caotiendattx/PC_ExtensionBoard/Docs/Canvas.png

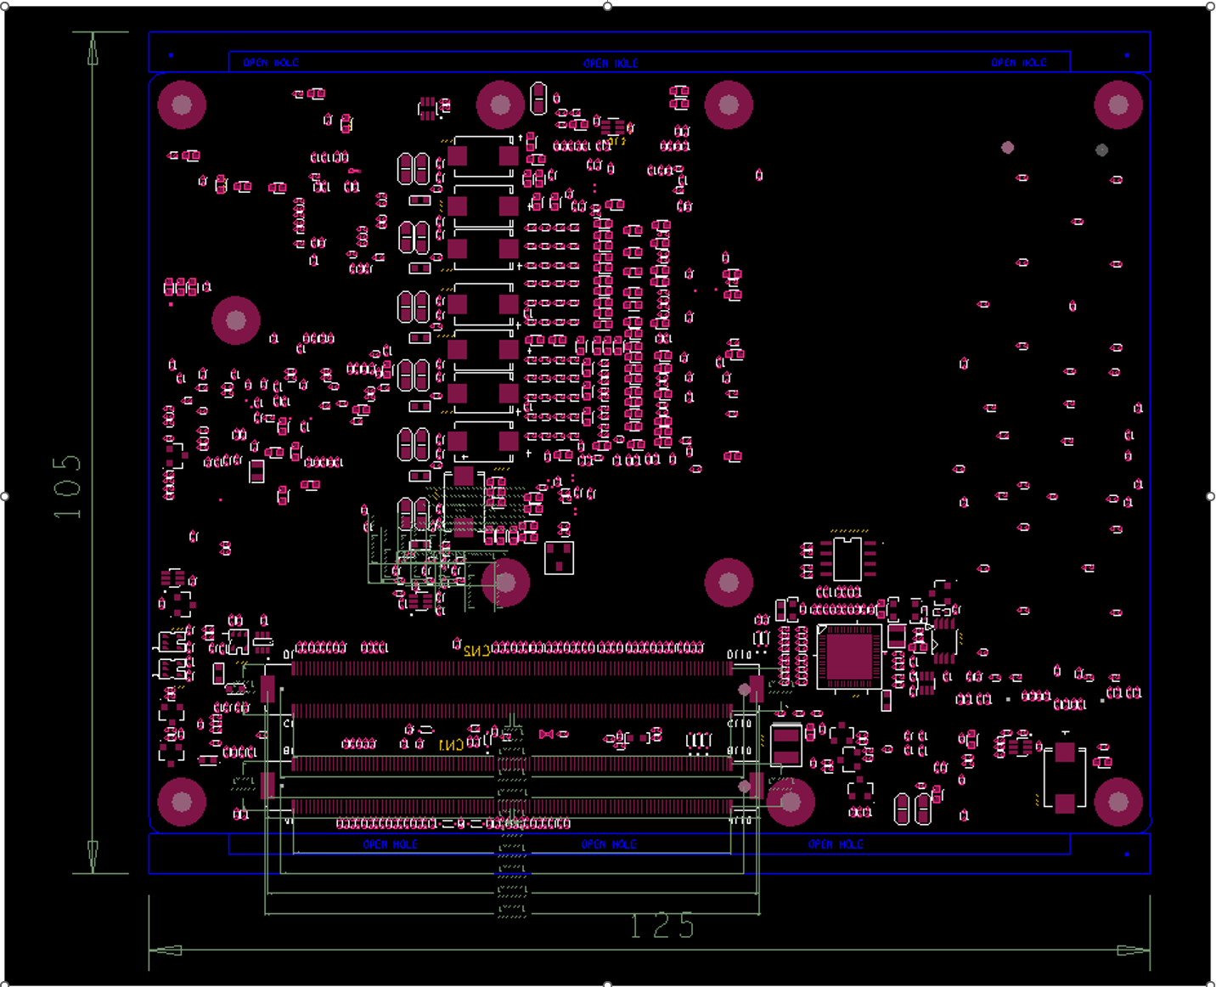
Docs/Canvas.png
