caotiendattx/PC_ExtensionBoard/Output/1.0/1.0_3D.png

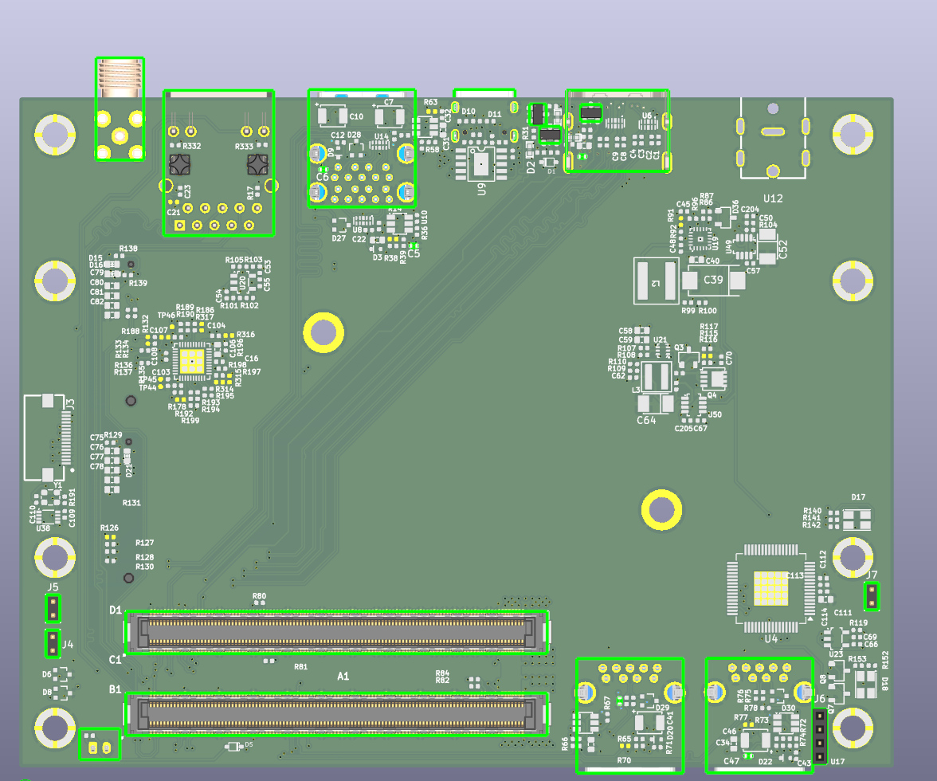
Output/1.0/1.0_3D.png
