caotiendattx/PC_ExtensionBoard/PC_ExtensionBoard/production/bom.csv

Designator | Footprint | Quantity | Value | LCSC Part #
BT1 | JST_PH_B2B-PH-K_1x02_P2.00mm_Vertical | 1 | Battery CMOS
C1, C19, C2, C20, C3, C30, C4, C8, C9 | 402 | 9 | 100nF/16V | C85960
C10, C41, C46, C7 | C_Pol_EIA-B | 4 | C_Pol_100u_10V_KEMET-T520-B | C600583
C103, C104, C107, C108, C109, C110, C112, C113, C114, C16, C17, C18, C204, C205, C23, C32, C37, C43, C48, C53, C54, C55 | 402 | 22 | C_100n_0402 | C85960
C106, C22, C31, C33, C34, C40, C58, C59 | 603 | 8 | C_22u_16V_0603 | C2762594
C11, C12, C38, C42, C44, C45, C47, C5, C50, C57, C6, C62, C66, C67, C69, C70 | 402 | 16 | C_1u_0402 | C2182694
C111, C75, C76, C77, C78, C79, C80, C81, C82 | 603 | 9 | C_22u_16V_0603 | CL10A226MO7JZNC
C39 | CAP-SMD_L7.3-W4.3-R-RD | 1 | C_Pol_68u_16V_Panasonic-TQC-D | C147770
C52, C64 | CAP-SMD_L3.5-W2.8 | 2 | C_Pol_100u_10V_KEMET-T520-B | C600583
C61 | 402 | 1 | 1uF/16V | C2182694
D1 | D_SOD-323 | 1 | 1N5819WS | C191023
D10, D11, D14, D19 | 402 | 4 | 0402ESDA-05N | C316049
D12 | 402 | 1 | PESD24VS1UL-N | C406227
D15, D16, D21 | 603 | 3 | LED_G_0603_LTST-C190GKT | LTST-C190GKT
D17, D18 | PLCC4_3.2x2.8mm | 2 | LED_RGB_PLCC4_ASMB_MTB1_0A3A2 | C2927824
D2, D4, D7 | D0402-BI | 3 | 0402ESDA-05N | C316049
D20, D22, D3, D9 | SOD-523 | 4 | PESD5Z5_0F | C552600
D27, D28, D29, D30, D6, D8 | SC70-3 | 6 | TPD2E2U06_SC70 | C1855726
D36 | SOT-23-3 | 1 | BAT54C | BAT54C
D5 | D_SOD-323 | 1 | D_Schottky | C168799
F1 | 603 | 1 | 6V/50mA | C7472508
H10, H11 | Spacer_Drill3.7mm_H2.5mm_9774025151R | 2 | Spacer_Drill3.7mm_H2.5mm_9774025151R | 9774025151R
H2, H3, H4, H5, H6, H7, H8, H9 | Spacer_Drill3.7mm_H5mm_9774050151R | 8 | Spacer_Drill3.7mm_H5mm_9774025151R | C7496631
HDMI1 | HDMI-SMD_HDMI-019S | 1 | HDMI_A | C111617
J100 | Bus_M.2_Socket_Key_E_TE_2199230-6 | 1 | Bus_M.2_2199230-2 | C23731731
J3 | FPC-SMD_P0.50-16P_FGS-XJ-H2.0 | 1 | Conn_01x16_MountingPin
J4, J5, J7 | PinHeader_1x02_P2.00mm_Vertical | 3 | Conn_01x02_Socket
J6 | PinSocket_1x04_P2.00mm_Vertical | 1 | Conn_01x04_Pin
J8 | Bus_M.2_Socket_Key_M_TE_1-2199230-6 | 1 | Bus_M.2_1-2199230-6 | C4710843
L2 | L_Coilcraft-XAL6030 | 1 | L_1u8_14A_Coilcraft-XAL6030 | XAL6030-182MEC
L3 | L_WE-MAPI-4020 | 1 | L_1u8_6.8A_WE-MAPI-4020 | C20636406
Q10, Q9 | SOT-23 | 2 | 2SK3018 | C727148
Q11 | SOT-23 | 1 | 2N7002 | C8545
Q3, Q7, Q8 | SOT-23-3 | 3 | BSS138-7-F | BSS138-7-F
Q4 | Vishay_PowerPAK_1212-8_Single | 1 | SI7613DN-T1-GE3 | SI7613DN-T1-GE3
R100, R107, R110 | 402 | 3 | R_15k_0402 | CR0402-FX-1502GLF
R101, R118 | 402 | 2 | R_100k_0402 | CR0402-FX-1003GLF
R102, R103, R119 | 402 | 3 | R_0R_0402 | ERJ2GE0R00X
R104, R113 | 402 | 2 | R_0R001_0805 | MSMA0805R0010FSM
R105, R191 | 402 | 2 | R_1k_0402 | CR0402-FX-1001GLF
R108, R116, R128, R136, R92, R96 | 402 | 6 | R_10k_0402 | CR0402-FX-1002GLF
R109 | 402 | 1 | R_110k_0402 | CR0402-FX-1103GLF
R117, R87 | 402 | 2 | R_30k_0402 | CR0402-FX-3002GLF
R126, R130, R132, R133, R134, R137, R192, R193, R194, R195, R32, R33, R38, R39, R58, R59, R61, R62, R65, R66, R68, R69, R72, R73, R75, R76 | 402 | 26 | R_0R_0402 | C242160
R129, R138, R139 | 402 | 3 | R_220R_0402 | CR0402-FX-2200GLF
R131 | 603 | 1 | R_0R_22.4A_0603 | PMR03EZPJ000
R14, R64, R71, R78 | 402 | 4 | R_2k2_0402 | C2076845
R140, R141, R142, R152, R153, R36, R60, R67, R74, R80, R81, R82, R84, R86 | 402 | 14 | R_10k_0402 | C202396
R15, R332, R333 | 402 | 3 | R_470R_0402 | C2077077
R17 | 402 | 1 | R_330R_0402 | C2077069
R186, R187, R189, R190, R196, R197, R198, R199 | 402 | 8 | R_1k_0402 | C202394
R28, R29, R31, R35 | 402 | 4 | 2.2K/1% | C25879
R37 | 402 | 1 | 10K/1% | C202396
R40 | 402 | 1 | 1K/1% | C202394
R41 | 402 | 1 | 1M/1% | C26083
R42 | 402 | 1 | 21.5K/1% | C25872
R47 | 402 | 1 | 24K/1% | C138026
R48 | 402 | 1 | 1K/1% | C11702
R99 | 402 | 1 | R_68k_0402 | CR0402-FX-6802GLF
RJ1 | RJ45-TH_HR911130A | 1 | HR911130A | C54408
SW1 | KEY-SMD_4P-L4.2-W3.2-P2.20-LS5.1-TL | 1 | K2-1808SN-A4SW | C92589
U1, U7 | USB-TH_USB3.0-A | 2 | HC-USB3.0-L168-WP | C7501850
U10, U13, U15, U17 | TSOT23-6 | 4 | AP22615A_TSOT26 | C2680357
U12 | DC-IN-TH_DC-528-2.0-HY | 1 | DC-528φ2.0(HY) | C2851176
U14, U16, U18, U8 | USON-10_2.5x1mm_P0.5mm | 4 | ESD204DQAR | C553132
U19 | QFN-20-1EP_3x3mm_P0.45mm_TPS56xxxx | 1 | TPS56C230 | TPS56C230RJER
U2 | SMA-TH_SMA-KWE | 1 | 10GHz | C7498154
U20 | SOT-23-5 | 1 | TPS3840PL30DBVR | TPS3840PL30DBVR
U21 | SOT-563 | 1 | TPS564247DRLR | TPS564247DRLR
U23 | SOT-23-5 | 1 | TLV73333PDBVT | TLV73333PDBVT
U3 | CORE_BOARD_CUSTOM_440_PIN | 1 | KBLH-E61_COMe_Type6_16U | C2761498
U37 | VFQFPN-40-1EP_5x5mm_P0.4mm_EP3.5x3.5mm | 1 | 9DBL0651CKILF | 9DBL0651CKILF
U38 | VSSOP-8_2.3x2mm_P0.5mm | 1 | 74AUP2G132 | 74AUP2G132
U4 | LQFP-64-1EP_10x10mm_P0.5mm_EP5x5mm | 1 | STM32G0B1RCT6 | C3034735
U49, U50 | SOT-23-8 | 2 | INA219AIDCNR | INA219AIDCNR
U5, U6 | DFN2510-10_L2.5-W1.0-P0.50-BL | 2 | TPAZ1023-04F | C2827676
U9 | ESSOP-10_L4.9-W3.9-P1.0-LS6.0-TL-EP | 1 | CH224K | C970725
USB1 | USB-A-TH_H181-AF2R06-12ALCR | 1 | HC-USB3.0-L175-2X1-P | C7501881
USBC1 | USB-C_SMD-TYPE-C-31-M-12_1 | 1 | J18 | C165948
Y1 | Oscillator_SMD_ECS_2520MV_2.5x2mm | 1 | Oscillator_32.768kHz_ECS_2520MV | ECS-327MVATX-2-CN-TR3
U333 | CORE_BOARD_CUSTOM_440_PIN | 1 | KBLH-E61_COMe_Type6_16U | C2761498
