caotiendattx/PC_ExtensionBoard/PC_ExtensionBoard_Lib2/parts/BORN_0402ESDA_05N/D0402_L1-W0.5-H0.4-LS1.0.step

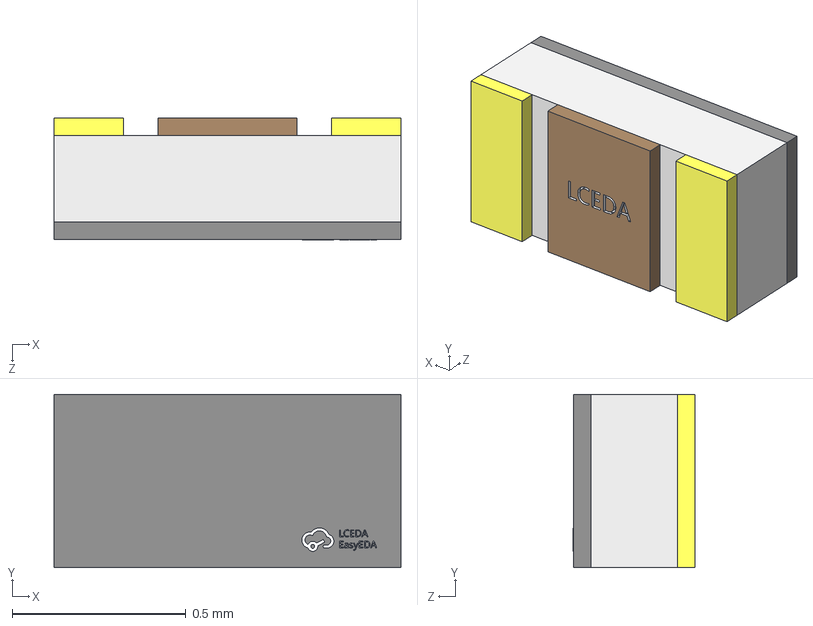
[picture p14: CAD file, 2026-06-15]
PC_ExtensionBoard_Lib2/parts/BORN_0402ESDA_05N/D0402_L1-W0.5-H0.4-LS1.0.step
1.00 x 0.5 x 0.351 mm
