caotiendattx/PC_ExtensionBoard/PC_ExtensionBoard_Lib2/parts/HANRUN_HR911130A/RJ45-TH_HR911130A.STEP

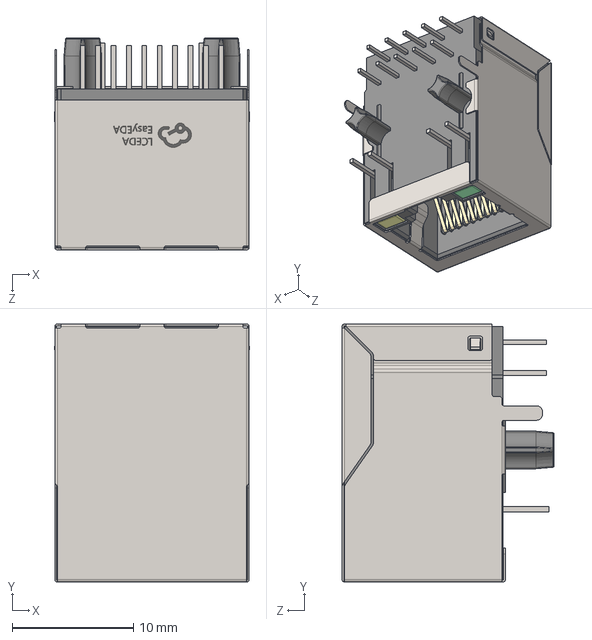
[picture p15: CAD file, 2026-06-11]
PC_ExtensionBoard_Lib2/parts/HANRUN_HR911130A/RJ45-TH_HR911130A.STEP
16.1 x 21.3 x 17.5 mm
