caotiendattx/PC_ExtensionBoard/PC_ExtensionBoard_Lib2/parts/Hong_Cheng_HC_USB3_0_L175_2X1_P/USB-A-TH_H181-AF2R06-12ALCR.STEP

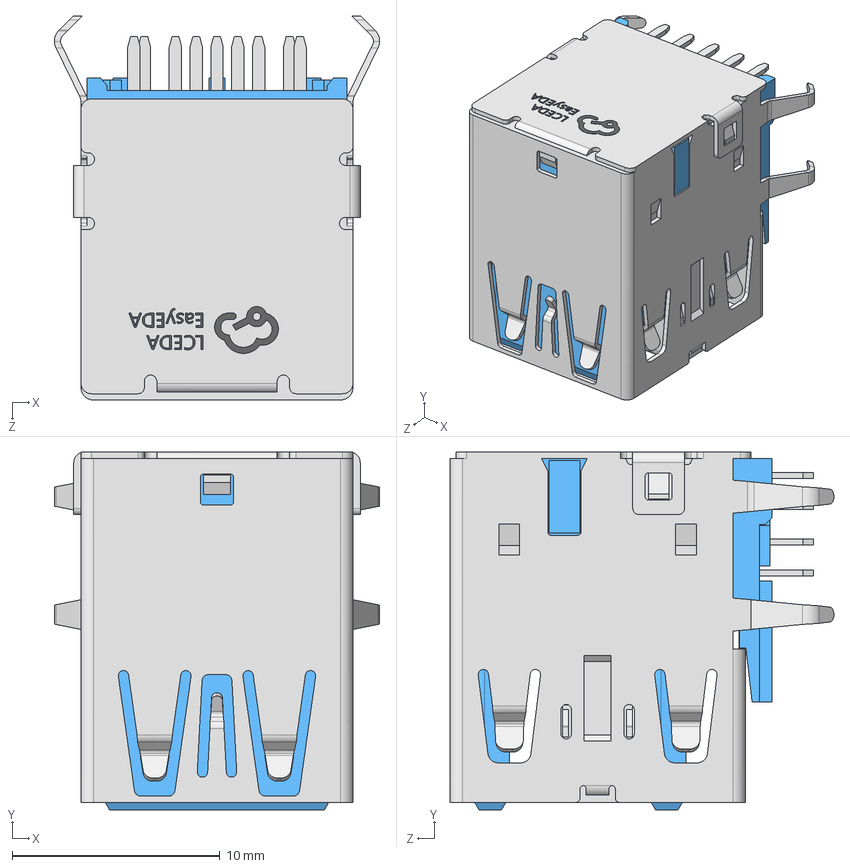
[picture p16: CAD file, 2026-04-27]
PC_ExtensionBoard_Lib2/parts/Hong_Cheng_HC_USB3_0_L175_2X1_P/USB-A-TH_H181-AF2R06-12ALCR.STEP
15.7 x 17.2 x 18.5 mm
