caotiendattx/PC_ExtensionBoard/PC_ExtensionBoard_Lib2/parts/JUSHUO_AFA01_S16FCC_00/FPC-SMD_P1.00-16P_FGS-XJ-H2.0.step

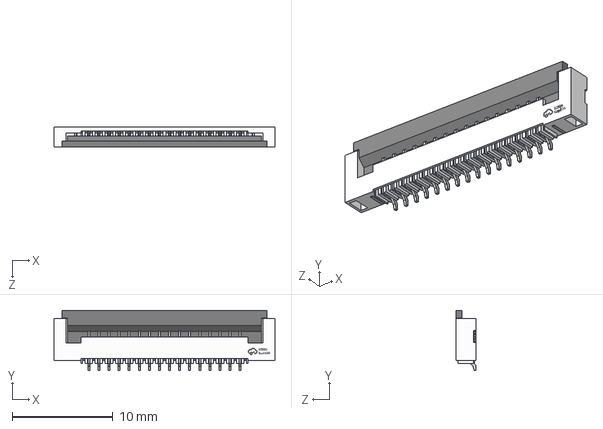
[picture p17: CAD file, 2026-06-14]
PC_ExtensionBoard_Lib2/parts/JUSHUO_AFA01_S16FCC_00/FPC-SMD_P1.00-16P_FGS-XJ-H2.0.step
21.9 x 5.97 x 2.01 mm
