caotiendattx/PC_ExtensionBoard/PC_ExtensionBoard_Lib2/parts/JUSHUO_AFC01_S16FCC_00/FPC-SMD_P0.50-16P_FGS-XJ-H2.0.step

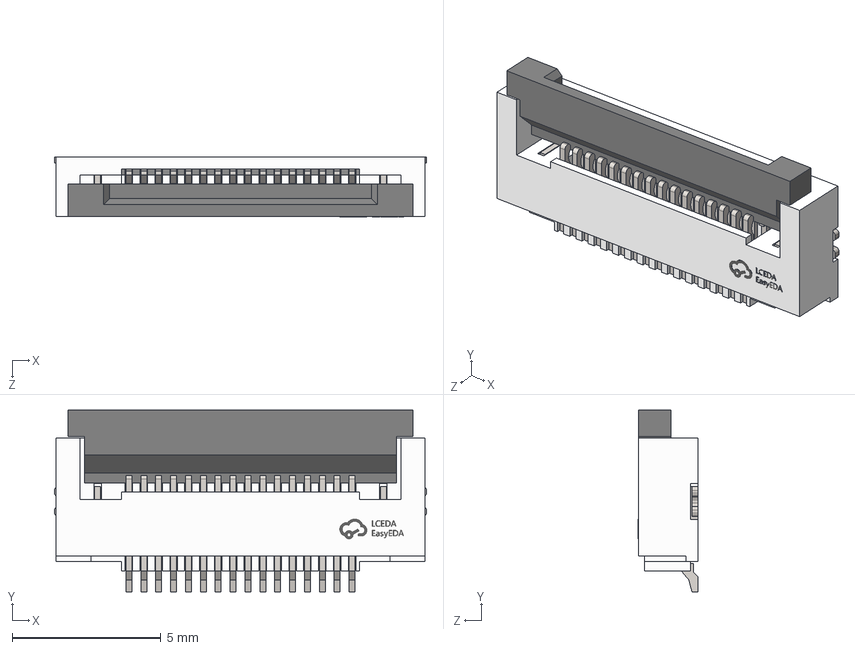
[picture p18: CAD file, 2026-06-14]
PC_ExtensionBoard_Lib2/parts/JUSHUO_AFC01_S16FCC_00/FPC-SMD_P0.50-16P_FGS-XJ-H2.0.step
12.5 x 6.10 x 2.01 mm
