caotiendattx/PC_ExtensionBoard/PC_ExtensionBoard_Lib2/parts/KEMET_T520B107M010ATE070/CASE-B_L3.5-W2.8-H1.9.step

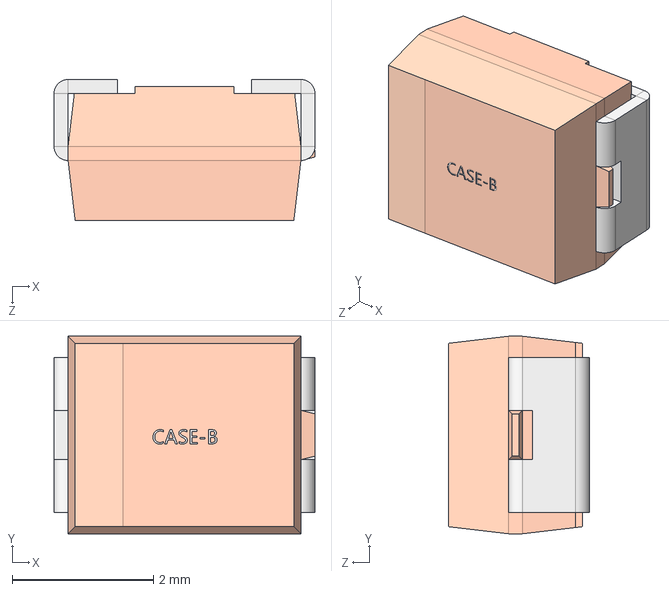
[picture p19: CAD file, 2026-06-15]
PC_ExtensionBoard_Lib2/parts/KEMET_T520B107M010ATE070/CASE-B_L3.5-W2.8-H1.9.step
3.70 x 2.80 x 2.00 mm
