caotiendattx/PC_ExtensionBoard/PC_ExtensionBoard_Lib2/parts/Korean_Hroparts_Elec_K2_1808SN_A4SW_01/KEY-SMD_4P-L4.2-W3.2-H2.5-LS5.1-P2.2.step

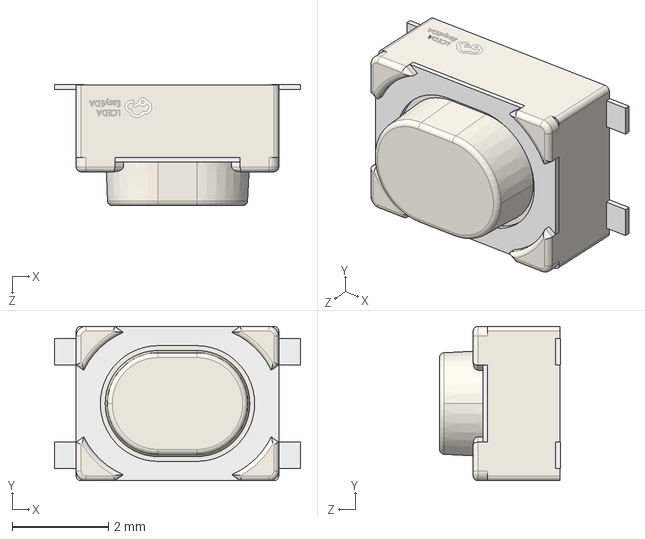
[picture p20: CAD file, 2026-06-11]
PC_ExtensionBoard_Lib2/parts/Korean_Hroparts_Elec_K2_1808SN_A4SW_01/KEY-SMD_4P-L4.2-W3.2-H2.5-LS5.1-P2.2.step
5.10 x 3.20 x 2.51 mm
