caotiendattx/PC_ExtensionBoard/PC_ExtensionBoard_Lib2/parts/Korean_Hroparts_Elec_PJ_393_7A/AUDIO-SMD_PJ-393-7A.step

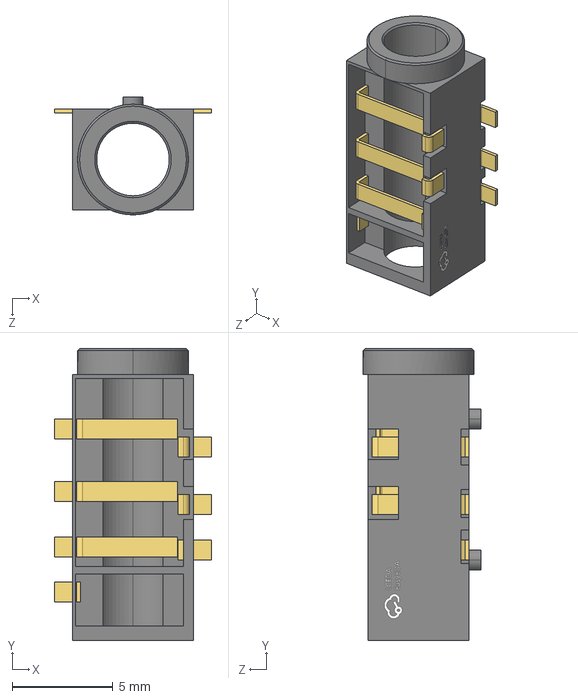
[picture p21: CAD file, 2026-06-11]
PC_ExtensionBoard_Lib2/parts/Korean_Hroparts_Elec_PJ_393_7A/AUDIO-SMD_PJ-393-7A.step
7.80 x 14.5 x 5.85 mm
