caotiendattx/PC_ExtensionBoard/PC_ExtensionBoard_Lib2/parts/PANASONIC_16TQC68MYF/CASE-E_L7.3-W4.3-H4.1.step

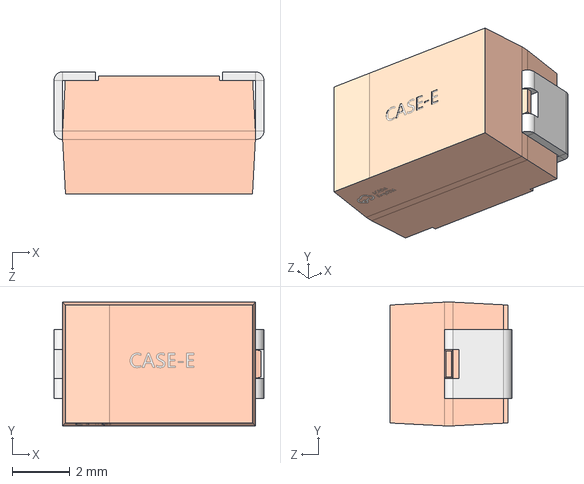
[picture p22: CAD file, 2026-06-15]
PC_ExtensionBoard_Lib2/parts/PANASONIC_16TQC68MYF/CASE-E_L7.3-W4.3-H4.1.step
7.30 x 4.30 x 4.25 mm
