caotiendattx/PC_ExtensionBoard/PC_ExtensionBoard_Lib2/parts/Shenzhen_Kinghelm_Elec_KH_FG0_5_H2_0_16PIN/FPC-SMD_KH-FG0.5-H2.0-16PIN.step

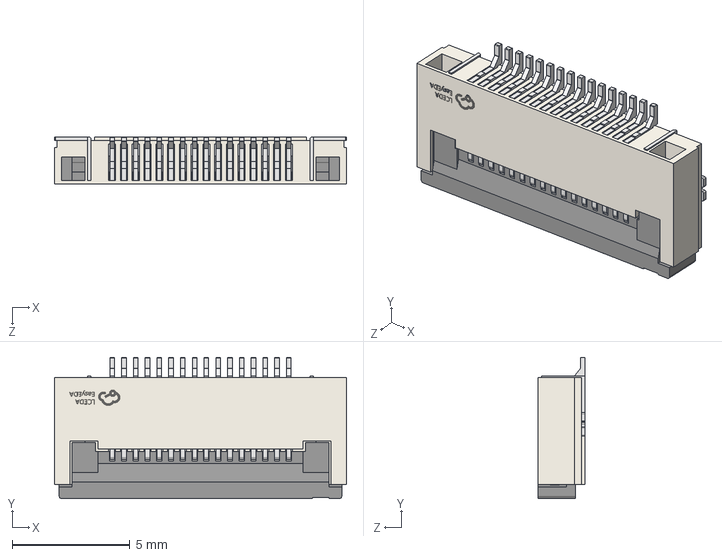
[picture p23: CAD file, 2026-06-11]
PC_ExtensionBoard_Lib2/parts/Shenzhen_Kinghelm_Elec_KH_FG0_5_H2_0_16PIN/FPC-SMD_KH-FG0.5-H2.0-16PIN.step
12.4 x 6.00 x 2.01 mm
