caotiendattx/PC_ExtensionBoard/PC_ExtensionBoard_Lib2/parts/SOFNG_HDMI_019S/HDMI-SMD_HDMI-019S.step

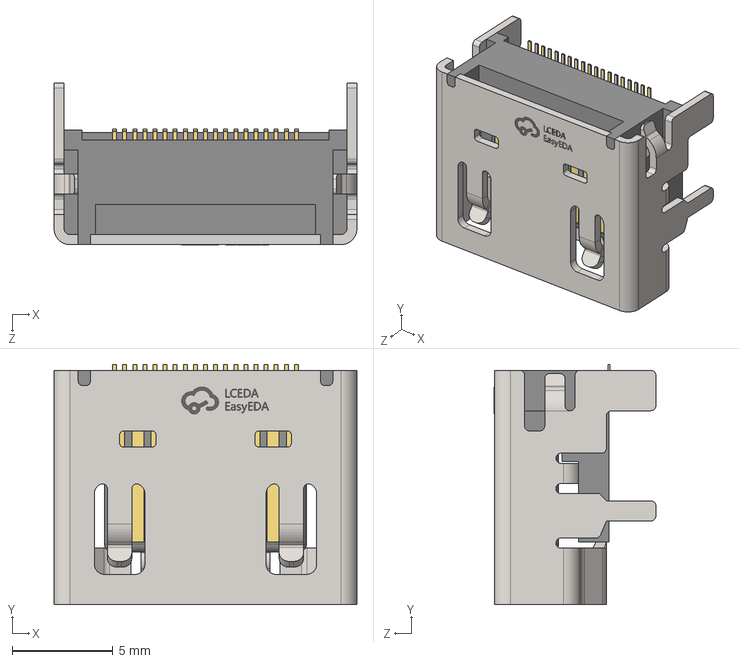
[picture p24: CAD file, 2026-04-27]
PC_ExtensionBoard_Lib2/parts/SOFNG_HDMI_019S/HDMI-SMD_HDMI-019S.step
15.0 x 11.9 x 8.01 mm
