caotiendattx/PC_ExtensionBoard/PC_ExtensionBoard_Lib2/parts/TE_Connectivity_1_2199230_6/PCIE-SMD_1-2199230-6.STEP

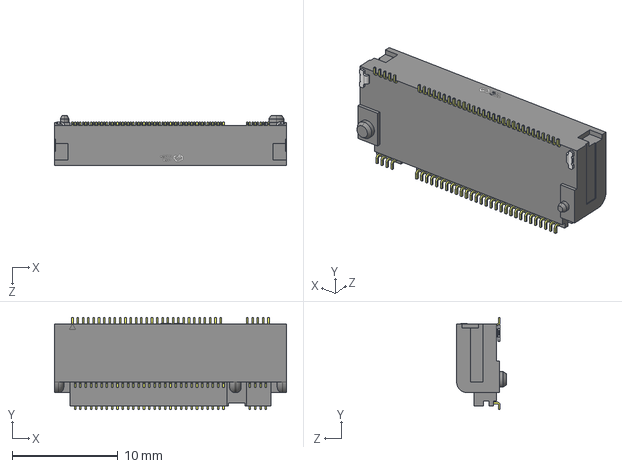
[picture p25: CAD file, 2026-06-11]
PC_ExtensionBoard_Lib2/parts/TE_Connectivity_1_2199230_6/PCIE-SMD_1-2199230-6.STEP
21.9 x 8.70 x 4.70 mm
