caotiendattx/PC_ExtensionBoard/PC_ExtensionBoard_Lib2/parts/TECH_PUBLIC_TPAZ1023_04F/DFN-10_L2.5-W1.0-H0.5-P0.50.step

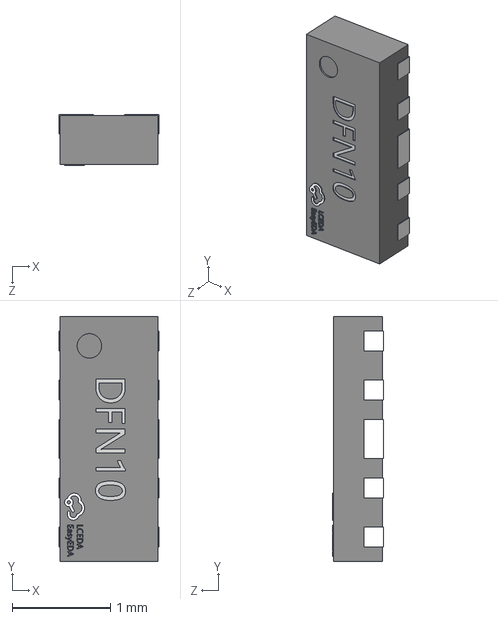
[picture p26: CAD file, 2026-06-15]
PC_ExtensionBoard_Lib2/parts/TECH_PUBLIC_TPAZ1023_04F/DFN-10_L2.5-W1.0-H0.5-P0.50.step
1.02 x 2.50 x 0.52 mm
