caotiendattx/PC_ExtensionBoard/PC_ExtensionBoard_Lib2/parts/Texas_Instruments_PCM2912APJTR/TQFP-32_L7.0-W7.0-H1.2-LS9.0-P0.80.step

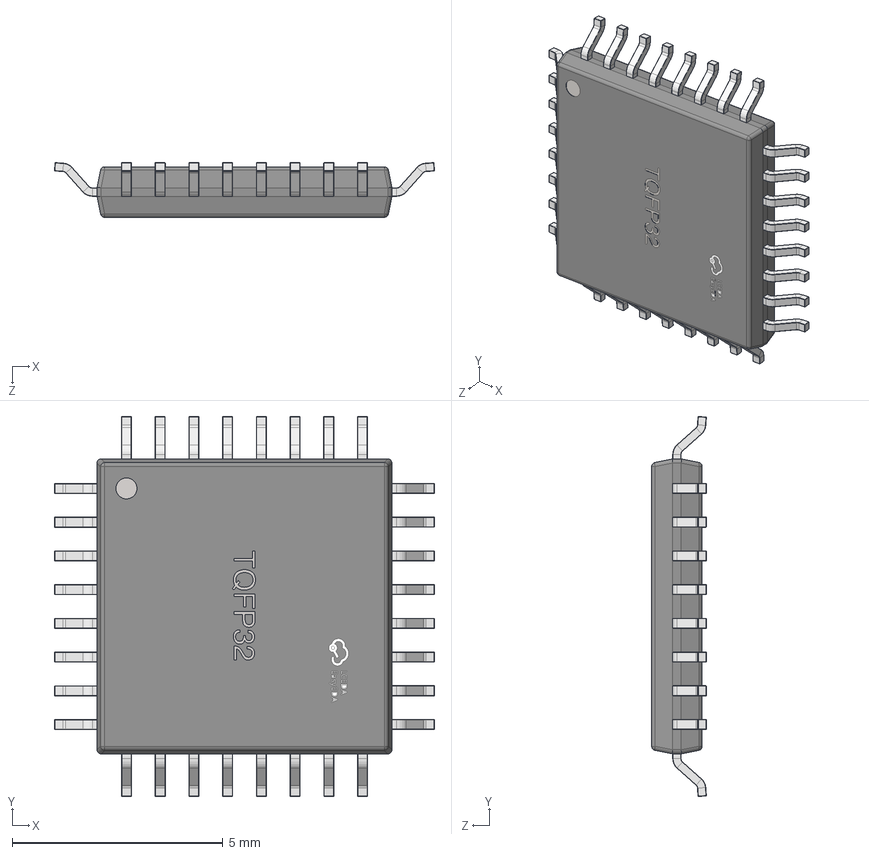
[picture p27: CAD file, 2026-06-11]
PC_ExtensionBoard_Lib2/parts/Texas_Instruments_PCM2912APJTR/TQFP-32_L7.0-W7.0-H1.2-LS9.0-P0.80.step
9.02 x 9.02 x 1.30 mm
