caotiendattx/PC_ExtensionBoard/PC_ExtensionBoard_Lib2/parts/XUNPU_FPC_05F_24PH20/FPC-SMD_24P-P0.50_FPC-05F-24PH20.STEP

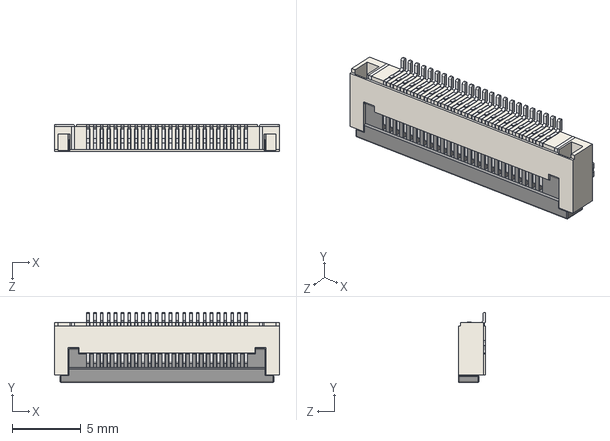
[picture p29: CAD file, 2026-06-11]
PC_ExtensionBoard_Lib2/parts/XUNPU_FPC_05F_24PH20/FPC-SMD_24P-P0.50_FPC-05F-24PH20.STEP
16.4 x 5.12 x 2.00 mm
