caotiendattx/PC_ExtensionBoard/(list of files, cad)

Other CAD files:
PC_ExtensionBoard_Lib2/parts/TE_CONNECTIVITY_2199230_2/PCIE-SMD_2199230-4.STEP
