caotiendattx/PC_ExtensionBoard/PC_ExtensionBoard/PC_ExtensionBoard.kicad_pcb

## KiCad design PC_ExtensionBoard/PC_ExtensionBoard.kicad_pcb (2026-06-24)

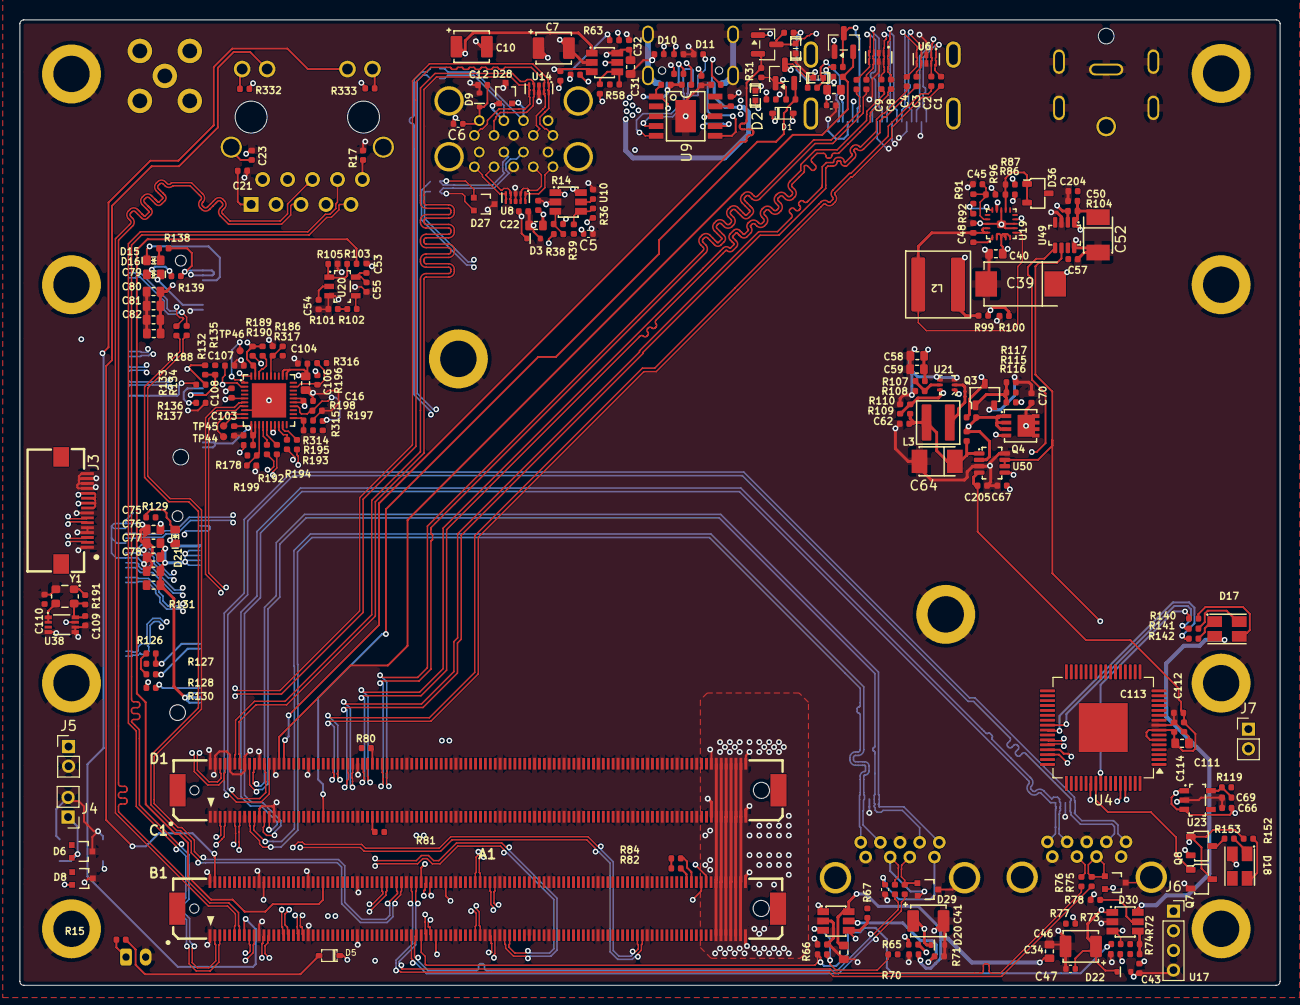
[picture p30: board PC_ExtensionBoard.kicad_pcb from above]

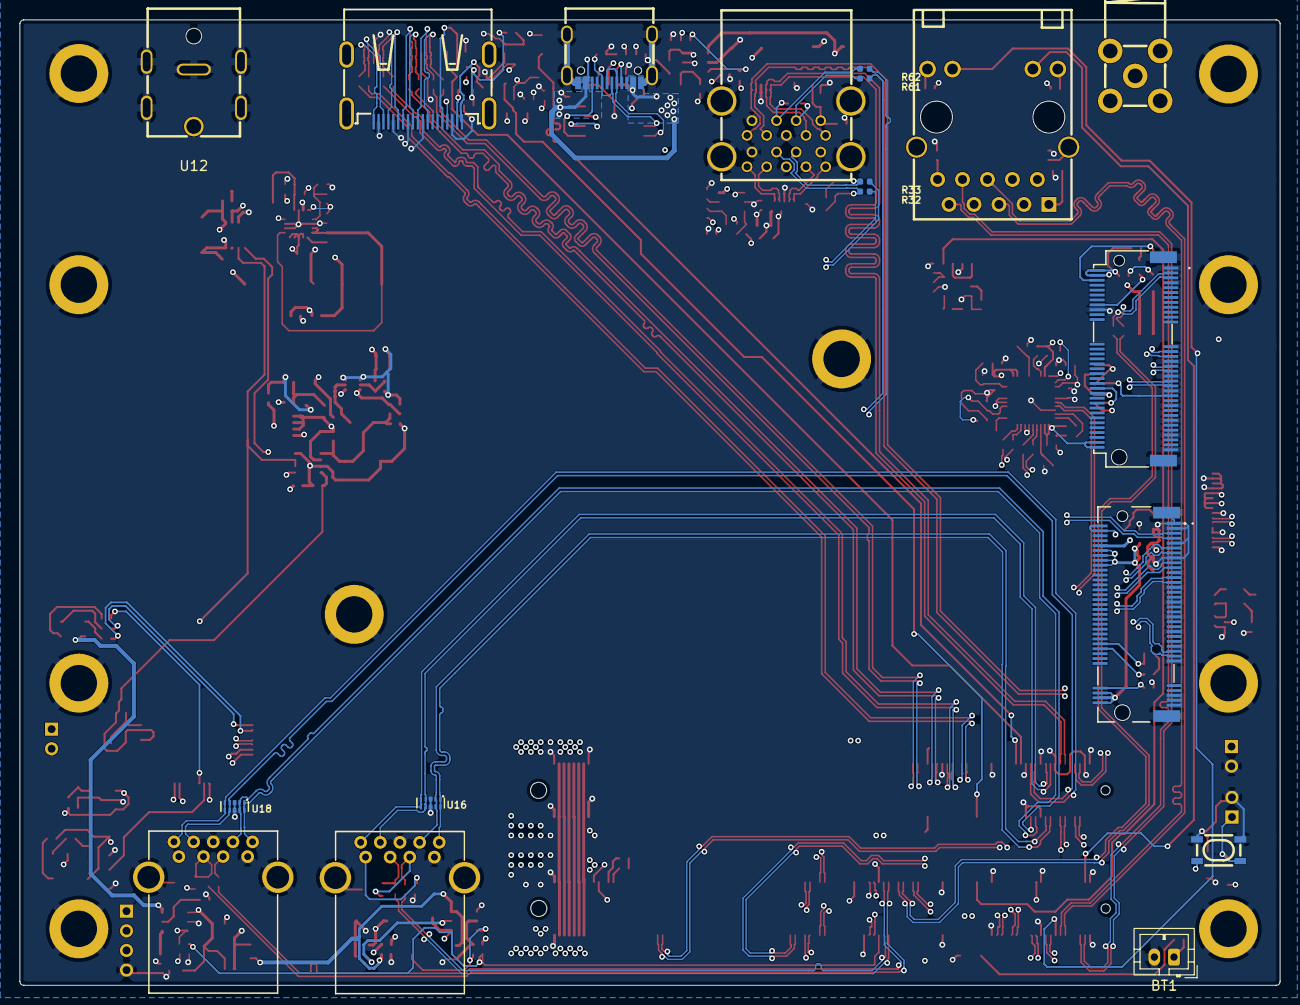
[picture p31: board PC_ExtensionBoard.kicad_pcb from below]

Board: 6 copper layers, 128.2 x 98.2 mm, 269 parts (22 on the bottom side), 216 nets.

Parts:
A1: Mech_M2_2280_H2.5mm
A4: Mech_M2_2230_H2.5mm
BT1: Battery CMOS; JST_PH_B2B-PH-K_1x02_P2.00mm_Vertical
C1, C2, C3, C4, C8, C9, C19, C20, C30: 100nF/16V; C_0402_1005Metric
C5, C6, C11, C12, C38, C42, C44, C45, C47, C50, C57, C62, C66, C67, C69, C70: C_1u_0402; C_0402_1005Metric
C7, C10, C41, C46: C_Pol_100u_10V_KEMET-T520-B; C_Pol_EIA-B
C16, C17, C18, C21, C23, C32, C37, C43, C48, C53, C54, C55, C103, C104, C107, C108, C109, C110, C112, C113, C114, C204, C205: C_100n_0402; C_0402_1005Metric
C22, C31, C33, C34, C40, C58, C59, C75, C76, C77, C78, C79, C80, C81, C82, C106, C111: C_22u_16V_0603; C_0603_1608Metric
C39: C_Pol_68u_16V_Panasonic-TQC-D; CAP-SMD_L7.3-W4.3-R-RD
C52, C64: C_Pol_100u_10V_KEMET-T520-B; CAP-SMD_L3.5-W2.8
C61: 1uF/16V; C_0402_1005Metric
D1: 1N5819WS; D_SOD-323
D2, D4, D7: 0402ESDA-05N; D0402-BI
D3, D9, D20, D22: PESD5Z5_0F; SOD-523
D5: D_Schottky; D_SOD-323
D6, D8, D27, D28, D29, D30: TPD2E2U06_SC70; SC70-3
D10, D11, D14, D19: 0402ESDA-05N; C_0402_1005Metric
D12: PESD24VS1UL-N; C_0402_1005Metric
D15, D16, D21: LED_G_0603_LTST-C190GKT; LED_0603_1608Metric_G
D17, D18: LED_RGB_PLCC4_ASMB_MTB1_0A3A2; PLCC4_3.2x2.8mm
D36: BAT54C; SOT-23-3
F1: 6V/50mA; R_0603_1608Metric
H2, H3, H4, H5, H6, H7, H8, H9: Spacer_Drill3.7mm_H5mm_9774025151R; Spacer_Drill3.7mm_H5mm_9774050151R
H10, H11: Spacer_Drill3.7mm_H2.5mm_9774025151R
HDMI1: HDMI_A; HDMI-SMD_HDMI-019S
J3: Conn_01x16_MountingPin; FPC-SMD_P0.50-16P_FGS-XJ-H2.0
J4, J5, J7: Conn_01x02_Socket; PinHeader_1x02_P2.00mm_Vertical
J6: Conn_01x04_Pin; PinSocket_1x04_P2.00mm_Vertical
J8: Bus_M.2_1-2199230-6; Bus_M.2_Socket_Key_M_TE_1-2199230-6
J100: Bus_M.2_2199230-2; Bus_M.2_Socket_Key_E_TE_2199230-6
L2: L_1u8_14A_Coilcraft-XAL6030; L_Coilcraft-XAL6030
L3: L_1u8_6.8A_WE-MAPI-4020; L_WE-MAPI-4020
Q3, Q7, Q8: BSS138-7-F; SOT-23-3
Q4: SI7613DN-T1-GE3; Vishay_PowerPAK_1212-8_Single
Q9, Q10: 2SK3018; SOT-23
Q11: 2N7002; SOT-23
R14, R64, R71, R78: R_2k2_0402; C_0402_1005Metric
R15, R332, R333: R_470R_0402; R_0402_1005Metric
R17: R_330R_0402; R_0402_1005Metric
R28, R29, R31, R35: 2.2K/1%; R_0402_1005Metric
R30, R36, R60, R63, R67, R70, R74, R77, R80, R81, R82, R84, R86, R92, R96, R108, R116, R127, R128, R135, R136, R140, R141, R142, R152, R153: R_10k_0402; R_0402_1005Metric
R32, R33, R38, R39, R58, R59, R61, R62, R65, R66, R68, R69, R72, R73, R75, R76, R102, R103, R115, R119, R126, R130, R132, R133, R134, R137, R178, R192, R193, R194, R195, R314, R315, R316, R317: R_0R_0402; R_0402_1005Metric
R37: 10K/1%; R_0402_1005Metric
R40, R48: 1K/1%; R_0402_1005Metric
R41: 1M/1%; R_0402_1005Metric
R42: 21.5K/1%; R_0402_1005Metric
R47: 24K/1%; C_0402_1005Metric
R87, R117: R_30k_0402; R_0402_1005Metric
R91, R99: R_68k_0402; R_0402_1005Metric
R100, R107, R110: R_15k_0402; R_0402_1005Metric
R101, R118: R_100k_0402; R_0402_1005Metric
R104, R113: R_0R001_0805; R_0402_1005Metric
R105, R186, R187, R188, R189, R190, R191, R196, R197, R198, R199: R_1k_0402; R_0402_1005Metric
R109: R_110k_0402; R_0402_1005Metric
R129, R138, R139: R_220R_0402; R_0402_1005Metric
R131: R_0R_22.4A_0603; R_0603_1608Metric
RJ1: HR911130A; RJ45-TH_HR911130A
SW1: K2-1808SN-A4SW; KEY-SMD_4P-L4.2-W3.2-P2.20-LS5.1-TL
TP44, TP45, TP46: TP_0.75mm_SMD; TP_SMD_0.75mm
U1, U7: HC-USB3.0-L168-WP; USB-TH_USB3.0-A
U2: 10GHz; SMA-TH_SMA-KWE
U3: KBLH-E61_COMe_Type6_16U; CORE_BOARD_CUSTOM_440_PIN
U4: STM32G0B1RCT6; LQFP-64-1EP_10x10mm_P0.5mm_EP5x5mm
U5, U6: TPAZ1023-04F; DFN2510-10_L2.5-W1.0-P0.50-BL
U8, U14, U16, U18: ESD204DQAR; USON-10_2.5x1mm_P0.5mm
U9: CH224K; ESSOP-10_L4.9-W3.9-P1.0-LS6.0-TL-EP
U10, U13, U15, U17: AP22615A_TSOT26; TSOT23-6
U12: DC-528φ2.0(HY); DC-IN-TH_DC-528-2.0-HY
U19: TPS56C230; QFN-20-1EP_3x3mm_P0.45mm_TPS56xxxx
U20: TPS3840PL30DBVR; SOT-23-5
U21: TPS564247DRLR; SOT-563
U23: TLV73333PDBVT; SOT-23-5
U37: 9DBL0651CKILF; VFQFPN-40-1EP_5x5mm_P0.4mm_EP3.5x3.5mm
U38: 74AUP2G132; VSSOP-8_2.3x2mm_P0.5mm
U49, U50: INA219AIDCNR; SOT-23-8
USB1: HC-USB3.0-L175-2X1-P; USB-A-TH_H181-AF2R06-12ALCR
USBC1: J18; USB-C_SMD-TYPE-C-31-M-12_1
Y1: Oscillator_32.768kHz_ECS_2520MV; Oscillator_SMD_ECS_2520MV_2.5x2mm

Connections:
5V_HDMI_VCC: C30.1, D1.1 (K), F1.1, R28.1, R29.1
+3.3V: C16.2, C17.2, C57.2, C79.2, C80.2, C81.2, C82.2, C103.2, C104.2, C106.2, C107.2, C108.2, C109.2, C110.2, J100.2 (3.3V), J100.4 (3.3V), J100.72 (3.3V), J100.74 (3.3V), Q9.1 (G), Q10.1 (G), Q11.1 (G), R30.2, R31.1, R35.1, R36.2, R41.1, R60.2, R63.2, R67.2, R70.2, R74.2, R77.2, R80.1, R81.1, R82.1, R84.1, R104.2, R127.2, R128.2, R129.2, R131.2, R135.2, R136.2, R138.2, R139.2, R187.1, R189.2, R190.1, R191.2, R332.2, R333.2, U37.5 (VDDR), U37.11 (VDDDIG3V3), U37.12 (VDDIO), U37.16 (VDD3V3), U37.17 (VDDIO), U37.25 (VDDA3V3), U37.26 (VDDIO), U37.31 (VDD3V3), U37.32 (VDDIO), U37.39 (VDDIO), U38.8 (VCC), U49.2 (IN-), Y1.4 (VDD)
+3V3_AON: C54.2, C111.2, C112.2, C113.2, C114.2, C204.2, C205.2, R119.2, U4.6 (VBAT), U4.8 (VDD), U20.2 (VDD), U49.4 (V_{S}), U49.7 (A0), U50.4 (V_{S})
+5V: C18.2, C22.2, C31.2, C32.2, C33.2, C34.2, C37.2, C43.2, C70.2, D1.2 (A), D17.4 (A), J3.9, J3.10, J3.11, J3.12, Q4.5 (D), R86.2, U10.6 (IN), U13.6 (IN), U15.6 (IN), U17.6 (IN)
+5V_AON: C66.2, C67.2, D18.4 (A), Q4.1 (S), Q4.2 (S), Q4.3 (S), R113.2, R118.2, U23.1 (VIN), U23.3 (EN), U50.2 (IN-)
+12V: C39.1, C40.2, C58.2, C59.2, D12.1 (K), J6.3, R37.1, R40.1, R107.2, R116.2, U3.A104 (VCC_12V), U3.A105 (VCC_12V), U3.A106 (VCC_12V), U3.A107 (VCC_12V), U3.A108 (VCC_12V), U3.A109 (VCC_12V), U3.B104 (VCC_12V), U3.B105 (VCC_12V), U3.B106 (VCC_12V), U3.B107 (VCC_12V), U3.B108 (VCC_12V), U3.B109 (VCC_12V), U3.C104 (VCC_12V), U3.C105 (VCC_12V), U3.C106 (VCC_12V), U3.C107 (VCC_12V), U3.C108 (VCC_12V), U3.C109 (VCC_12V), U3.D104 (VCC_12V), U3.D105 (VCC_12V), U3.D106 (VCC_12V), U3.D107 (VCC_12V), U3.D108 (VCC_12V), U3.D109 (VCC_12V), U12.4, U19.2 (V_{IN}), U19.3 (V_{IN}), U19.4 (V_{IN}), U19.5 (V_{IN}), U21.1 (V_{IN}), USBC1.A4B9 (VBUS), USBC1.B4A9 (VBUS)
/HDMI/DDC_SCL: D2.2 (A2), HDMI1.15 (SCL), Q9.3 (D), R29.2
/HDMI/DDC_SDA: D4.2 (A2), HDMI1.16 (SDA), Q10.3 (D), R28.2
/HDMI/DDI1.SCL: Q9.2 (S), R35.2, U3.D15 (DDI1_CTRLCLK_AUX+)
/HDMI/DDI1.SDA: Q10.2 (S), R31.2, U3.D16 (DDI1_CTRLDATA_AUX)
/HDMI/DDI1.TX0+: C1.1, U3.D26 (DDI1_PAIR0+)
/HDMI/DDI1.TX0-: C2.1, U3.D27 (DDI1_PAIR0-)
/HDMI/DDI1.TX1+: C3.1, U3.D29 (DDI1_PAIR1+)
/HDMI/DDI1.TX1-: C4.1, U3.D30 (DDI1_PAIR1-)
/HDMI/DDI1.TX2+: C8.1, U3.D32 (DDI1_PAIR2+)
/HDMI/DDI1.TX2-: C9.1, U3.D33 (DDI1_PAIR2-)
/HDMI/DDI1.TX3+: C19.1, U3.D36 (DDI1_PAIR3+)
/HDMI/DDI1.TX3-: C20.1, U3.D37 (DDI1_PAIR3-)
/HDMI/DDI1_AUX_SEL: R80.2, U3.D34 (DDI1_DDC_AUX_SEL)
/HDMI/DDI1_HPD: Q11.2 (S), R41.2, U3.C24 (DDI1_HPD)
/HDMI/DDI2_AUX_SEL: R81.2, U3.C34 (DDI2_DDC_AUX_SEL)
/HDMI/HPD: D7.2 (A2), HDMI1.19 (HPD), R48.2
/HDMI/TMDS_CK+: C19.2, HDMI1.10 (CK+), U5.4, U5.7 (NC)
/HDMI/TMDS_CK-: C20.2, HDMI1.12 (CK-), U5.5, U5.6 (NC)
/HDMI/TMDS_D0+: C8.2, HDMI1.7 (D0+), U5.1, U5.10 (NC)
/HDMI/TMDS_D0-: C9.2, HDMI1.9 (D0-), U5.2, U5.9 (NC)
/HDMI/TMDS_D1+: C3.2, HDMI1.4 (D1+), U6.4, U6.7 (NC)
/HDMI/TMDS_D1-: C4.2, HDMI1.6 (D1-), U6.5, U6.6 (NC)
/HDMI/TMDS_D2+: C1.2, HDMI1.1 (D2+), U6.1, U6.10 (NC)
/HDMI/TMDS_D2-: C2.2, HDMI1.3 (D2-), U6.2, U6.9 (NC)
/M.2 Key E/PCIE_REF3.CK+: J100.49 (REFCLK0_N), R195.2
/M.2 Key E/PCIE_REF3.CK-: J100.47 (REFCLK0_P), R194.2
/M.2 Key E/PCIe_B1x2.RX0+: J100.43 (PER0_N), U3.A55 (PCIE_TX4+)
/M.2 Key E/PCIe_B1x2.RX0-: J100.41 (PER0_P), U3.A56 (PCIE_TX4-)
/M.2 Key E/PCIe_B1x2.TX0+: J100.37 (PET0_N), U3.B55 (PCIE_RX4+)
/M.2 Key E/PCIe_B1x2.TX0-: J100.35 (PET0_P), U3.B56 (PCIE_RX4-)
/M.2 Key E/SUSCLK: R130.2, R137.2, U38.7 (1Y)
/M.2 Key E/USB.D+: R133.1, U3.B40 (USB5+)
/M.2 Key E/USB.D-: R134.1, U3.B39 (USB5-)
/M.2 Key E/WIFI_BT_USB_D_N: J100.5 (USB_D_N), R134.2
/M.2 Key E/WIFI_BT_USB_D_P: J100.3 (USB_D_P), R133.2
/M.2 Key E/~CLKREQ: J100.53 (~CLKREQ0), R136.1
/M.2 Key E/~LED_1: D15.1 (C), J100.6 (~LED_1)
/M.2 Key E/~LED_2: D16.1 (C), J100.16 (~LED_2)
/M.2 Key E/~PERST_D: J100.52 (~PERST0), R132.2, R135.1
/M.2 Key M #1/M2_3V3: C75.2, C76.2, C77.2, C78.2, J8.2 (3V3), J8.4 (3V3), J8.12 (3V3), J8.14 (3V3), J8.16 (3V3), J8.18 (3V3), J8.70 (3V3), J8.72 (3V3), J8.74 (3V3), R131.1
/M.2 Key M #1/PCIE1-4_SATA_PCIE: R82.2, U3.B98 (PCIE1-4_SATA_PCIE)
/M.2 Key M #1/PCIE_REF0.CK+: J8.55 (REFCLK_P), R192.2
/M.2 Key M #1/PCIE_REF0.CK-: J8.53 (REFCLK_N), R193.2
/M.2 Key M #1/PCIe_B1x4.RX0+: J8.41 (PER0_N), U3.A68 (PCIE_TX0+)
/M.2 Key M #1/PCIe_B1x4.RX0-: J8.43 (PER0_P), U3.A69 (PCIE_TX0-)
/M.2 Key M #1/PCIe_B1x4.RX1+: J8.29 (PER1_N), U3.A64 (PCIE_TX1+)
/M.2 Key M #1/PCIe_B1x4.RX1-: J8.31 (PER1_P), U3.A65 (PCIE_TX1-)
/M.2 Key M #1/PCIe_B1x4.RX2+: J8.17 (PER2_N), U3.A61 (PCIE_TX2+)
/M.2 Key M #1/PCIe_B1x4.RX2-: J8.19 (PER2_P), U3.A62 (PCIE_TX2-)
/M.2 Key M #1/PCIe_B1x4.RX3+: J8.5 (PER3_N), U3.A58 (PCIE_TX3+)
/M.2 Key M #1/PCIe_B1x4.RX3-: J8.7 (PER3_P), U3.A59 (PCIE_TX3-)
/M.2 Key M #1/PCIe_B1x4.TX0+: J8.47 (PET0_N), U3.B68 (PCIE_RX0+)
/M.2 Key M #1/PCIe_B1x4.TX0-: J8.49 (PET0_P), U3.B69 (PCIE_RX0-)
/M.2 Key M #1/PCIe_B1x4.TX1+: J8.35 (PET1_N), U3.B64 (PCIE_RX1+)
/M.2 Key M #1/PCIe_B1x4.TX1-: J8.37 (PET1_P), U3.B65 (PCIE_RX1-)
/M.2 Key M #1/PCIe_B1x4.TX2+: J8.23 (PET2_N), U3.B61 (PCIE_RX2+)
/M.2 Key M #1/PCIe_B1x4.TX2-: J8.25 (PET2_P), U3.B62 (PCIE_RX2-)
/M.2 Key M #1/PCIe_B1x4.TX3+: J8.11 (PET3_N), U3.B58 (PCIE_RX3+)
/M.2 Key M #1/PCIe_B1x4.TX3-: J8.13 (PET3_P), U3.B59 (PCIE_RX3-)
/M.2 Key M #1/~CLKREQ: J8.52 (~CLKREQ), R128.1
/M.2 Key M #1/~PERST_D: J8.50 (~PERST), R126.2, R127.1
/MISC/DIF0+: R192.1, U37.14 (DIF0+)
/MISC/DIF0-: R193.1, U37.15 (DIF0-)
/MISC/DIF1+: R194.1, U37.18 (DIF1+)
/MISC/DIF1-: R195.1, U37.19 (DIF1-)
/MISC/FAN.PWM: J6.1, U3.B101 (FAN_PWMOUT)
/MISC/FAN.TACH: J6.2, U3.B102 (FAN_TACHIN)
/MISC/LED_B: R140.1, U4.56 (PD6)
/MISC/LED_G: R141.1, U4.40 (PD8)
/MISC/LED_R: R142.1, U4.41 (PD9)
/MISC/MCU_SWCLK: J7.2, U4.46 (PA14)
/MISC/MCU_SWDIO: J7.1, U4.45 (PA13)
/MISC/PCIE_REFIN.CK+: U3.A88 (PCIE_CLK+), U37.6 (CLK_IN+)
/MISC/PCIE_REFIN.CK-: U3.A89 (PCIE_CLK-), U37.7 (CLK_IN-)
/MISC/PWR_OK: Q7.1 (G), U4.55 (PD5)
/MISC/SATA0-1_SATA_PCIE: R84.2, U3.B99 (SATA0-1_SATA_PCIE)
/MISC/SATA0.RX+: J3.6, U3.A19 (SATA0_RX+)
/MISC/SATA0.RX-: J3.7, U3.A20 (SATA0_RX-)
/MISC/SATA0.TX+: J3.2, U3.A16 (SATA0_TX+)
/MISC/SATA0.TX-: J3.3, U3.A17 (SATA0_TX-)
/MISC/USB7.D+: U3.B37 (USB7+), U4.44 (PA10/PA12)
/MISC/USB7.D-: U3.B36 (USB7-), U4.43 (PA9/PA11)
/MISC/~PWR_OK: Q7.3 (D), Q8.1 (G), R152.1, U4.54 (PD4)
/PC_CoreBoard/GBE0.MDI0+: RJ1.P2 (MDI0+), U3.A13 (GBE0_MDI0+)
/PC_CoreBoard/GBE0.MDI0-: RJ1.P3 (MDI0-), U3.A12 (GBE0_MDI0-)
/PC_CoreBoard/GBE0.MDI1+: RJ1.P4 (MDI1+), U3.A10 (GBE0_MDI1+)
/PC_CoreBoard/GBE0.MDI1-: RJ1.P7 (MDI1-), U3.A9 (GBE0_MDI1-)
/PC_CoreBoard/GBE0.MDI2+: RJ1.P5 (MDI2+), U3.A7 (GBE0_MDI2+)
/PC_CoreBoard/GBE0.MDI2-: RJ1.P6 (MDI2-), U3.A6 (GBE0_MDI2-)
/PC_CoreBoard/GBE0.MDI3+: RJ1.P8 (MDI3+), U3.A3 (GBE0_MDI3+)
/PC_CoreBoard/GBE0.MDI3-: RJ1.P9 (MDI3-), U3.A2 (GBE0_MDI3-)
/PC_CoreBoard/PWRBTN: D6.2, J4.1, SW1.3, SW1.4, U3.B12 (PWRBTN#)
/PC_CoreBoard/PWR_OK: R103.2, U3.B24 (PWR_OK)
/PC_CoreBoard/RESETBTN: D8.2, J5.1, U3.B49 (SYS_RESET#)
/PC_CoreBoard/USB0.D+: R32.1, U3.A46 (USB0+)
/PC_CoreBoard/USB0.D-: R33.1, U3.A45 (USB0-)
/PC_CoreBoard/USB1.D+: R62.1, U3.B46 (USB1+)
/PC_CoreBoard/USB1.D-: R61.1, U3.B45 (USB1-)
/PC_CoreBoard/USB2.D+: R69.1, U3.A43 (USB2+)
/PC_CoreBoard/USB2.D-: R68.1, U3.A42 (USB2-)
/PC_CoreBoard/USB3.D+: R76.1, U3.B43 (USB3+)
/PC_CoreBoard/USB3.D-: R75.1, U3.B42 (USB3-)
/PC_CoreBoard/USBSS0.RX+: U3.C4 (USB_SSRX0+), U8.2, U8.9, USB1.15 (SSRX+)
/PC_CoreBoard/USBSS0.RX-: U3.C3 (USB_SSRX0-), U8.1, U8.10, USB1.14 (SSRX-)
/PC_CoreBoard/USBSS0.TX+: U3.D4 (USB_SSTX0+), U8.5, U8.6, USB1.18 (SSTX+)
/PC_CoreBoard/USBSS0.TX-: U3.D3 (USB_SSTX0-), U8.4, U8.7, USB1.17 (SSTX-)
/PC_CoreBoard/USBSS1.RX+: U3.C7 (USB_SSRX1+), U14.2, U14.9, USB1.6 (SSRX+)
/PC_CoreBoard/USBSS1.RX-: U3.C6 (USB_SSRX1-), U14.1, U14.10, USB1.5 (SSRX-)
/PC_CoreBoard/USBSS1.TX+: U3.D7 (USB_SSTX1+), U14.5, U14.6, USB1.9 (SSTX+)
/PC_CoreBoard/USBSS1.TX-: U3.D6 (USB_SSTX1-), U14.4, U14.7, USB1.8 (SSTX-)
/PC_CoreBoard/USBSS2.RX+: U1.6 (SSRX+), U3.C10 (USB_SSRX2+), U16.2, U16.9
/PC_CoreBoard/USBSS2.RX-: U1.5 (SSRX-), U3.C9 (USB_SSRX2-), U16.1, U16.10
/PC_CoreBoard/USBSS2.TX+: U1.9 (SSTX+), U3.D10 (USB_SSTX2+), U16.5, U16.6
/PC_CoreBoard/USBSS2.TX-: U1.8 (SSTX-), U3.D9 (USB_SSTX2-), U16.4, U16.7
/PC_CoreBoard/USBSS3.RX+: U3.C13 (USB_SSRX3+), U7.6 (SSRX+), U18.2, U18.9
/PC_CoreBoard/USBSS3.RX-: U3.C12 (USB_SSRX3-), U7.5 (SSRX-), U18.1, U18.10
/PC_CoreBoard/USBSS3.TX+: U3.D13 (USB_SSTX3+), U7.9 (SSTX+), U18.5, U18.6
/PC_CoreBoard/USBSS3.TX-: U3.D12 (USB_SSTX3-), U7.8 (SSTX-), U18.4, U18.7
/PC_CoreBoard/USB_0_1_OC#: R38.1, R59.1, U3.B44 (USB_0_1_OC#)
/PC_CoreBoard/USB_2_3_OC#: R66.1, R73.1, U3.A44 (USB_2_3_OC#)
/PC_CoreBoard/VCC_RTC: D5.1 (K), U3.A47 (VCC_RTC)
/PC_CoreBoard/~GBE0_ACT: RJ1.12, U3.B2 (GBE0_ACT#)
/PC_CoreBoard/~GBE0_LINK: RJ1.13, U3.A8 (GBE0_LINK#)
/Power/CC1: D14.2 (A2), U9.7 (CC1), USBC1.A5 (CC1)
/Power/CC2: D19.2 (A2), U9.6 (CC2), USBC1.B5 (CC2)
/Power/I2C.SCL: U4.60 (PB6), U49.5 (SCL), U50.5 (SCL)
/Power/I2C.SDA: U4.61 (PB7), U49.6 (SDA), U50.6 (SDA), U50.7 (A0)
/Power/PG_{1V0}: R101.2, R102.1
/Power/PG_{3V3}: R96.1, U19.9 (PG)
/Power/PWR_C_D+: D11.2 (A2), U9.4 (DP), USBC1.A6 (DP1), USBC1.B6 (DP2)
/Power/PWR_C_D-: D10.2 (A2), U9.5 (DM), USBC1.A7 (DN1), USBC1.B7 (DN2)
/USB_RJ45/EN_0B: R36.1, R39.2, U10.4 (EN)
/USB_RJ45/EN_1B: R58.2, R60.1, U13.4 (EN)
/USB_RJ45/EN_2B: R65.2, R67.1, U15.4 (EN)
/USB_RJ45/EN_3B: R72.2, R74.1, U17.4 (EN)
/USB_RJ45/FLG_0B: R30.1, R38.2, U10.3 (FLG)
/USB_RJ45/FLG_1B: R59.2, R63.1, U13.3 (FLG)
/USB_RJ45/FLG_2B: R66.2, R70.1, U15.3 (FLG)
/USB_RJ45/FLG_3B: R73.2, R77.1, U17.3 (FLG)
/USB_RJ45/GbE.CTREF: C21.1, RJ1.P1
/USB_RJ45/P0_D+: D27.2, R32.2, USB1.12 (D+)
/USB_RJ45/P0_D-: D27.1, R33.2, USB1.11 (D-)
/USB_RJ45/P0_ISET: R14.2, U10.5 (ISET)
/USB_RJ45/P0_VBUS: C5.2, C7.1, C11.2, D3.1 (C), U10.1 (OUT), USB1.10 (VBUS)
/USB_RJ45/P1_D+: D28.2, R62.2, USB1.3 (D+)
/USB_RJ45/P1_D-: D28.1, R61.2, USB1.2 (D-)
/USB_RJ45/P1_ISET: R64.2, U13.5 (ISET)
/USB_RJ45/P1_VBUS: C6.2, C10.1, C12.2, D9.1 (C), U13.1 (OUT), USB1.1 (VBUS)
/USB_RJ45/P2_D+: D29.2, R69.2, U1.3 (D+)
/USB_RJ45/P2_D-: D29.1, R68.2, U1.2 (D-)
/USB_RJ45/P2_ISET: R71.2, U15.5 (ISET)
/USB_RJ45/P2_VBUS: C38.2, C41.1, C42.2, D20.1 (C), U1.1 (VBUS), U15.1 (OUT)
/USB_RJ45/P3_D+: D30.2, R76.2, U7.3 (D+)
/USB_RJ45/P3_D-: D30.1, R75.2, U7.2 (D-)
/USB_RJ45/P3_ISET: R78.2, U17.5 (ISET)
/USB_RJ45/P3_VBUS: C44.2, C46.1, C47.2, D22.1 (C), U7.1 (VBUS), U17.1 (OUT)
GND: BT1.2 (-), C5.1, C6.1, C7.2, C10.2, C11.1, C12.1, C16.1, C17.1, C18.1, C21.2, C22.1, C23.2, C30.2, C31.1, C32.1, C33.1, C34.1, C37.1, C38.1, C39.2, C40.1, C41.2, C42.1, C43.1, C44.1, C45.1, C46.2, C47.1, C50.1, C52.2, C53.1, C54.1, C55.1, C57.1, C58.1, C59.1, C61.2, C62.1, C64.2, C66.1, C67.1, C69.1, C70.1, C75.1, C76.1, C77.1, C78.1, C79.1, C80.1, C81.1, C82.1, C103.1, C104.1, C106.1, C107.1, C108.1, C109.1, C110.1, C111.1, C112.1, C113.1, C114.1, C204.1, C205.1, D2.1 (A1), D3.2 (A), D4.1 (A1), D6.3, D7.1 (A1), D8.3, D9.2 (A), D10.1 (A1), D11.1 (A1), D12.2 (A), D14.1 (A1), D19.1 (A1), D20.2 (A), D22.2 (A), D27.3, D28.3, D29.3, D30.3, H2.1, H3.1, H4.1, H5.1, H6.1, H7.1, H8.1, H9.1, H10.1, H11.1, HDMI1.2 (D2S), HDMI1.5 (D1S), HDMI1.8 (D0S), HDMI1.11 (CKS), HDMI1.17 (GND), J3.1, J3.4, J3.5, J3.8, J3.13, J3.14, J3.15, J3.16, J4.2, J5.2, J6.4, J8.1 (GND), J8.3 (GND), J8.9 (GND), J8.15 (GND), J8.21 (GND), J8.27 (GND), J8.33 (GND), J8.39 (GND), J8.45 (GND), J8.51 (GND), J8.57 (GND), J8.71 (GND), J8.73 (GND), J8.75 (GND), J8.MP1 (MP), J8.MP2 (MP), J100.1 (GND), J100.7 (GND), J100.18 (GND), J100.33 (GND), J100.39 (GND), J100.45 (GND), J100.51 (GND), J100.57 (GND), J100.63 (GND), J100.69 (GND), J100.75 (GND), J100.MP, Q3.2 (S), Q7.2 (S), Q8.2 (S), R14.1, R17.2, R42.2, R47.2, R64.1, R71.1, R78.1, R87.2, R92.1, R100.1, R101.1, R105.1, R108.1, R110.1, R117.2, R186.2, R188.2, R196.2, R197.2, R198.2, R199.2, SW1.1, SW1.2, U1.4 (GND), U1.7 (GND_DRAN), U1.10 (SH), U3.A1 (GND), U3.A11 (GND), U3.A21 (GND), U3.A31 (GND), U3.A41 (GND), U3.A51 (GND), U3.A57 (GND), U3.A60 (GND), U3.A66 (GND), U3.A70 (GND), U3.A80 (GND), U3.A90 (GND), U3.A110 (GND), U3.B1 (GND), U3.B11 (GND), U3.B21 (GND), U3.B31 (GND), U3.B41 (GND), U3.B51 (GND), U3.B60 (GND), U3.B70 (GND), U3.B80 (GND), U3.B90 (GND), U3.B110 (GND), U3.C1 (GND), U3.C2 (GND), U3.C5 (GND), U3.C8 (GND), U3.C11 (GND), U3.C14 (GND), U3.C21 (GND), U3.C31 (GND), U3.C41 (GND), U3.C51 (GND), U3.C60 (GND), U3.C67 (GND), U3.C70 (GND), U3.C73 (GND), U3.C76 (GND), U3.C84 (GND), U3.C87 (GND), U3.C90 (GND), U3.C93 (GND), U3.C96 (GND), U3.C100 (GND), U3.C103 (GND), U3.C110 (GND), U3.D1 (GND), U3.D2 (GND), U3.D5 (GND), U3.D8 (GND), U3.D11 (GND), U3.D14 (GND), U3.D21 (GND), U3.D31 (GND), U3.D41 (GND), U3.D51 (GND), U3.D60 (GND), U3.D67 (GND), U3.D70 (GND), U3.D73 (GND), U3.D76 (GND), U3.D80 (GND), U3.D84 (GND), U3.D87 (GND), U3.D90 (GND), U3.D93 (GND), U3.D96 (GND), U3.D100 (GND), U3.D103 (GND), U3.D110 (GND), U4.9 (VSS), U5.3 (VSS), U5.8 (VSS), U6.3 (VSS), U6.8 (VSS), U7.4 (GND), U7.7 (GND_DRAN), U7.10 (SH), U8.3, U8.8, U9.11 (GND), U10.2 (GND), U12.1, U12.2, U12.3, U12.5, U12.6, U13.2 (GND), U14.3, U14.8, U15.2 (GND), U16.3, U16.8, U17.2 (GND), U18.3, U18.8, U19.7 (PGND), U19.8 (PGND), U19.13 (AGND), U19.18 (PGND), U19.21 (PGND), U20.3 (GND), U21.3 (GND), U21.4 (AGND), U23.2 (GND), U37.8 (GNDDIG), U37.41 (EPAD), U38.4 (GND), U38.5 (2A), U38.6 (2B), U49.3 (GND), U49.8 (A1), U50.3 (GND), U50.8 (A1), USB1.4 (GND), USB1.7 (GND_DRAIN), USB1.13 (GND), USB1.16 (GND_DRAIN), USB1.19 (GND), USB1.20 (GND), USBC1.1 (EH), USBC1.2 (EH), USBC1.3 (EH), USBC1.4 (EH), USBC1.A1B12 (GND), USBC1.B1A12 (GND), Y1.2 (GND)
unnamed: BT1.1 (+), R15.1
unnamed: C23.1, R17.1, RJ1.P10, RJ1.SHIELD0, RJ1.SHIELD1
unnamed: C48.2, L2.1, U19.6 (SW), U19.19 (SW), U19.20 (SW)
unnamed: D5.2 (A), R15.2
unnamed: D15.2 (A), R138.1
unnamed: D16.2 (A), R139.1
unnamed: D17.3 (C_{B}), R140.2
unnamed: D17.2 (C_{G}), R141.2
unnamed: D17.1 (C_{R}), R142.2
unnamed: D18.2 (C_{G}), R152.2
unnamed: D18.1 (C_{R}), R153.2
unnamed: D21.2 (A), R129.1
unnamed: D21.1 (C), J8.10 (LED)
unnamed: F1.2, HDMI1.18 (+5V)
unnamed: HDMI1.20 (SHD), HDMI1.21 (SHD), HDMI1.22 (SHD), HDMI1.23 (SHD)
unnamed: J8.68 (SUSCLK), R130.1
unnamed: J100.50 (SUSCLK), R137.1
unnamed: Q3.3 (D), Q4.4 (G), R118.1
unnamed: Q3.1 (G), R115.2, R116.1, R117.1
unnamed: Q8.3 (D), R153.1
unnamed: Q11.3 (D), R42.1, R48.1
unnamed: R332.1, RJ1.11
unnamed: R333.1, RJ1.14
unnamed: R47.1, U9.9 (CFG1)
unnamed: R37.2, U9.8 (VBUS)
unnamed: C61.1, R40.2, U9.1 (VDD)
unnamed: C48.1, U19.1 (BST)
unnamed: D36.1, D36.2, R86.1, R87.1, U19.12 (EN)
unnamed: R99.1, R100.2, U19.14 (FB)
unnamed: R91.1, R92.2, U19.15 (MODE)
unnamed: C45.2, R91.2, R96.2, U19.17 (V_{CC})
unnamed: C53.2, C55.2, U20.5 (CT)
unnamed: R102.2, U20.4 (~MR)
unnamed: R103.1, R105.2, U20.1 (~RESET)
unnamed: R107.1, R108.2, U21.5 (EN)
unnamed: R109.1, R110.2, U21.6 (FB)
unnamed: L3.1, U21.2 (SW)
unnamed: C69.2, R119.1, U23.5 (VOUT)
unnamed: TP46.1 (1_1), U37.1 (SADR_{TRI})
unnamed: TP44.1 (1_1), U37.9 (SCLK)
unnamed: TP45.1 (1_1), U37.10 (SDAT)
unnamed: R190.2, U37.40 (~CKPWRGD_PD)
unnamed: R187.2, R188.1, U37.2 (~HIBW_BYPM_LOBW)
unnamed: R178.2, R199.1, U37.13 (~OE0)
unnamed: R198.1, R314.2, U37.21 (~OE1)
unnamed: R197.1, R315.2, U37.24 (~OE2)
unnamed: R196.1, R316.2, U37.29 (~OE3)
unnamed: R186.1, R317.2, U37.35 (~OE4)
unnamed: R189.1, U37.38 (~OE5)
unnamed: U38.1 (1A), U38.2 (1B), Y1.3 (OUT)
unnamed: C50.2, C52.1, L2.2, R99.2, R104.1, U49.1 (IN+)
unnamed: C62.2, C64.1, L3.2, R109.2, R113.1, U50.1 (IN+)
unnamed: R191.1, Y1.1 (EN)
