caotiendattx/PC_ExtensionBoard/(commit log)

2026-04-19 Add Connector with correct dimensions
    [PC_ExtensionBoard.kicad_pcb, PC_ExtensionBoard.kicad_sch]
2026-04-20 update 3d
    [PC_ExtensionBoard.kicad_pcb, PC_ExtensionBoard.kicad_sch]
2026-04-27 update footprint with 3D
    [AUDIO-IN-SMD_PJ-327A_C22355751.STEP, CONN-SMD_QT002206-4131-3H.stp, DC-IN-TH_DC-044A-20A.step, HDMI-SMD_HDMI-019S.step, PC_ExtensionBoard.kicad_pcb, PC_ExtensionBoard.kicad_sch, RJ45-TH_L16.3-W15.8-H13.3.step, SMA-TH_SMA-KWE.step]
2026-04-28 finish 3D file for integration
    [PC_ExtensionBoard.kicad_pcb]
2026-05-14 Update Symbol for Coreboard
    [CONN-TH_40P_X1321FR-2X20-C43D24.step, Ethernet.kicad_sch, HDMI.kicad_sch, HDR-SMD_16P-P2.54-V-F-R2-C8-S2.54-LS7.3.STEP, HDR-SMD_40P-P2.54-F-LS-2X20P-R2.step, HDR-TH_40P-P2.54-H-F-R2-C20-S2.54-W8.5.step, PC_Coreboard.kicad_sch, PC_ExtensionBoard.kicad_pcb]
2026-05-18 update schematic: add pattern
    [HDMI.kicad_sch, M.2 Key E.kicad_sch, M.2 Key M #1.kicad_sch, MISC.kicad_sch, PC_Coreboard.kicad_sch, PC_ExtensionBoard.kicad_pcb, PC_ExtensionBoard.kicad_sch, Power.kicad_sch]
2026-06-02 update Schematic
    [AUDIO-IN-SMD_PJ-327A_C22355751.STEP, CONN-SMD_QT002206-4131-3H.stp, CONN-TH_40P_X1321FR-2X20-C43D24.step, DC-IN-TH_DC-044A-20A.step, HDMI-SMD_HDMI-019S.step, HDR-SMD_16P-P2.54-V-F-R2-C8-S2.54-LS7.3.STEP, HDR-SMD_40P-P2.54-F-LS-2X20P-R2.step, HDR-TH_40P-P2.54-H-F-R2-C20-S2.54-W8.5.step]
2026-06-03 components placement R1
    [M.2 Key E.kicad_sch, M.2 Key M #1.kicad_sch, MISC.kicad_sch, PC_Coreboard.kicad_sch, PC_ExtensionBoard.kicad_pcb, PC_ExtensionBoard.kicad_sch, Power.kicad_sch, USB-A-TH_H181-AF2R06-12ALCR.STEP]
2026-06-06 refactor project
    [CONN-SMD_QT002206-4131-3H.stp, HDMI.kicad_sch, M.2 Key E.kicad_sch, M.2 Key M #1.kicad_sch, MISC.kicad_sch, PC_Coreboard.kicad_sch, Power.kicad_sch, USB-A-TH_H181-AF2R06-12ALCR.STEP]
2026-06-06 re-link symbol
    [Ethernet.kicad_sch, HDMI.kicad_sch, M.2 Key E.kicad_sch, M.2 Key M #1.kicad_sch, MISC.kicad_sch, PC_Coreboard.kicad_sch, PC_ExtensionBoard.kicad_pcb, PC_ExtensionBoard.kicad_sch]
2026-06-11 update LCSC for HDMI
    [AUDIO-SMD_PJ-393-7A.step, HDMI-SMD_HDMI-019S.step, HDMI.kicad_sch, KEY-SMD_4P-L4.2-W3.2-H2.5-LS5.1-P2.2.step, M.2 Key E.kicad_sch, MISC.kicad_sch, PC_Coreboard.kicad_sch, PC_ExtensionBoard.kicad_pcb]
2026-06-11 update LCSC
    [FPC-SMD_24P-P0.50_FPC-05F-24PH20.STEP, FPC-SMD_KH-FG0.5-H2.0-16PIN.step, HDMI.kicad_sch, MISC.kicad_sch, PCIE-SMD_1-2199230-6.STEP, PCIE-SMD_2199230-4.STEP, PC_Coreboard.kicad_sch, PC_ExtensionBoard.kicad_pcb]
2026-06-14 schematic changes
    [FPC-SMD_P0.50-16P_FGS-XJ-H2.0.step, FPC-SMD_P1.00-16P_FGS-XJ-H2.0.step, HDMI.kicad_sch, MISC.kicad_sch, PC_Coreboard.kicad_sch, PC_ExtensionBoard.kicad_pcb, Power.kicad_sch]
2026-06-15 update LCSC Number
    [CASE-B_L3.5-W2.8-H1.9.step, CASE-E_L7.3-W4.3-H4.1.step, D0402_L1-W0.5-H0.4-LS1.0.step, DFN-10_L2.5-W1.0-H0.5-P0.50.step, ESSOP-10_L4.9-W3.9-P1.0-LS6.0-TL-EP.step, HDMI.kicad_sch, M.2 Key E.kicad_sch, M.2 Key M #1.kicad_sch]
2026-06-17 update diff pair routing
    [HDMI.kicad_sch, M.2 Key E.kicad_sch, M.2 Key M #1.kicad_sch, MISC.kicad_sch, PC_ExtensionBoard.kicad_pcb, USB.kicad_sch]
2026-06-18 attempts with impedance control
    [HDMI.kicad_sch, M.2 Key E.kicad_sch, M.2 Key M #1.kicad_sch, MISC.kicad_sch, PC_ExtensionBoard.kicad_pcb, PC_ExtensionBoard.kicad_sch]
2026-06-21 update Ethernet routing
    [PC_ExtensionBoard.kicad_pcb]
2026-06-21 finished highspeed routing
    [PC_ExtensionBoard.kicad_pcb, Power.kicad_sch, USB.kicad_sch]
2026-06-21 layout update
    [PC_ExtensionBoard.kicad_pcb]
2026-06-21 update layout
    [PC_ExtensionBoard.kicad_pcb]
2026-06-21 bug fixes
    [M.2 Key M #1.kicad_sch, MISC.kicad_sch, PC_ExtensionBoard.kicad_pcb, Power.kicad_sch, bom.csv, designators.csv, positions.csv]
2026-06-21 bug fixes: DRC
    [PC_ExtensionBoard.kicad_pcb]
2026-06-24 DRC Bug fixes
    [PC_ExtensionBoard.kicad_pcb]
